allovaro/minecraft-jukebox-nfc/cad/inside.png

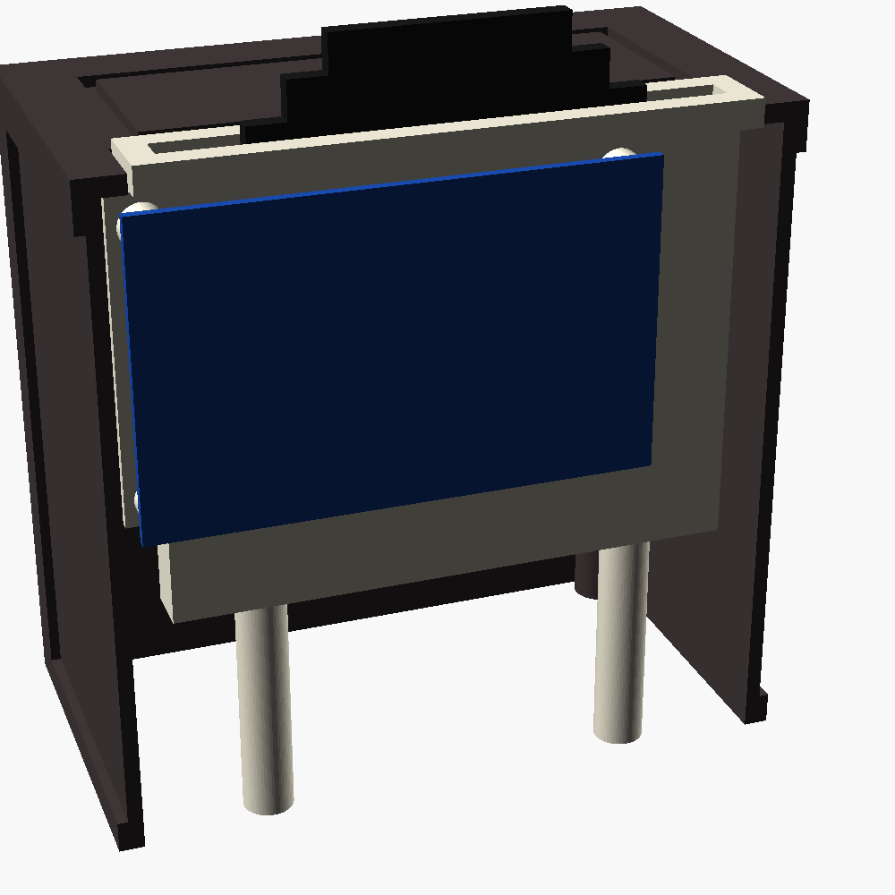
cad/inside.png
