allovaro/minecraft-jukebox-nfc/cad/stl/slot_unit.stl

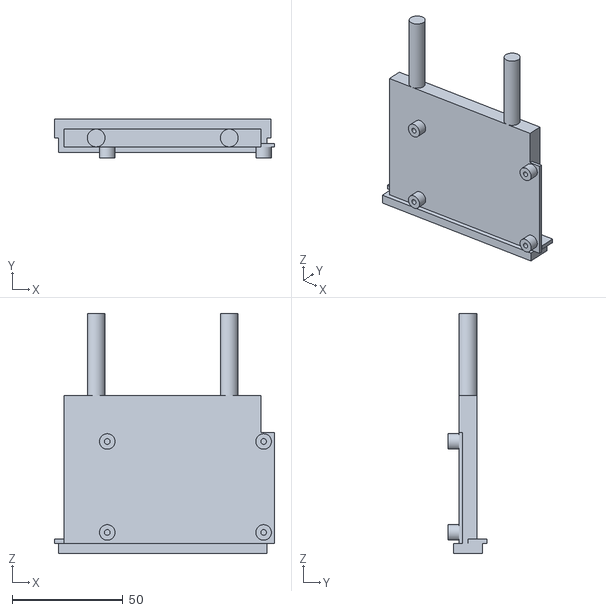
[picture p3: CAD file, 2026-10-28]
cad/stl/slot_unit.stl
99.4 x 17.5 x 108.2
