allovaro/minecraft-jukebox-nfc/cad/stl/body.stl

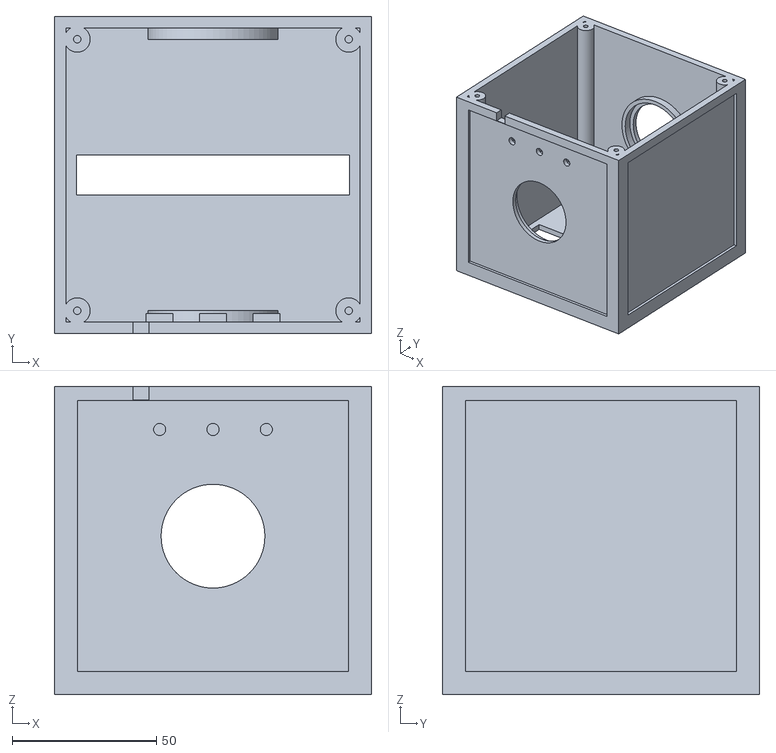
[picture p4: CAD file, 2026-10-28]
cad/stl/body.stl
110.0 x 110.0 x 107.0
