allovaro/minecraft-jukebox-nfc/cad/stl/disc.stl

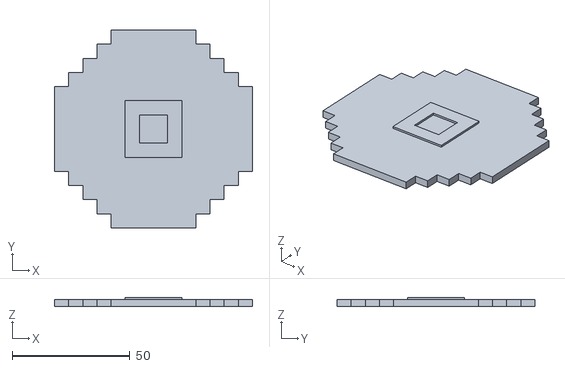
[picture p5: CAD file, 2026-10-28]
cad/stl/disc.stl
84.0 x 84.0 x 3.80
