allovaro/minecraft-jukebox-nfc/cad/stl/bottom.stl

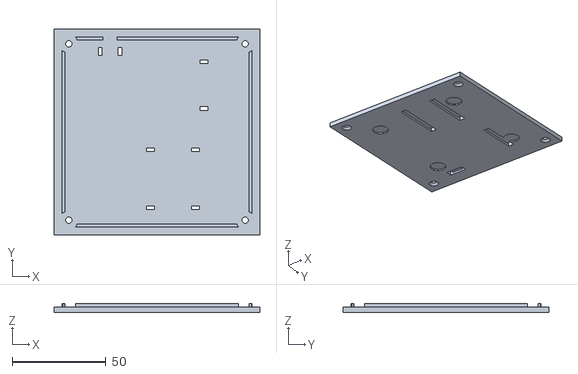
[picture p6: CAD file, 2026-10-28]
cad/stl/bottom.stl
110.0 x 110.0 x 5.00
