allovaro/minecraft-jukebox-nfc/cad/stl/panel_top.stl

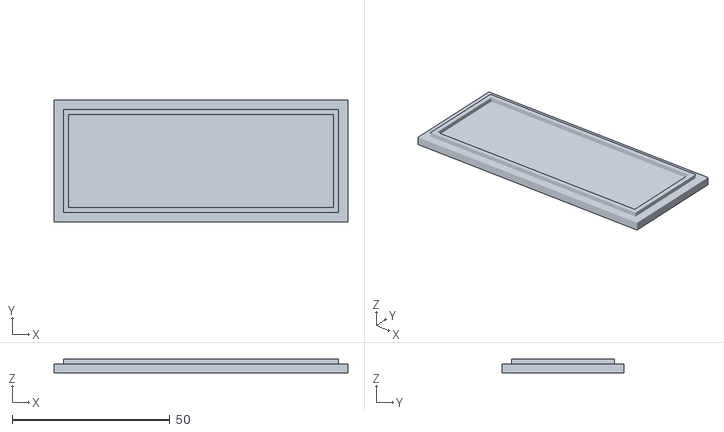
[picture p7: CAD file, 2026-10-28]
cad/stl/panel_top.stl
93.3 x 38.6 x 4.30
