allovaro/minecraft-jukebox-nfc/cad/stl/panel_side.stl

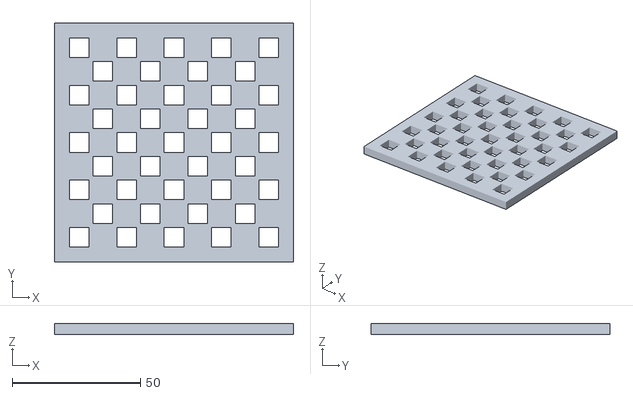
[picture p8: CAD file, 2026-10-28]
cad/stl/panel_side.stl
93.3 x 93.3 x 4.40
