allovaro/minecraft-jukebox-nfc/(commit log)

2026-10-28 Minecraft jukebox: NFC music box for kids
    ESPHome firmware (ESP32-S3, PN532, MAX98357A, WS2812), Home Assistant
    automation, parametric OpenSCAD model with ready-to-print STLs.
    [body.stl, bottom.stl, disc.stl, music_cube.scad, panel_side.stl, panel_top.stl, slot_unit.stl]
2026-10-28 Fix issues found in model audit
    - Speaker rings and button holders are now open (0.1 mm skin removed)
    - Power cable exits through a notch under the back wall, with zip-tie strain relief
    - Slot unit clamped between roof and bottom plate by two legs
    - Looser fits for slot rim, top panel groove and side panels
    - Taller PN532 standoffs so M3x6 screws fit; zip-tie mounts for ESP32 and amp
    - ESP32 placed with room for the USB-C plug; buttons always centered
    - Correct pause / color-change heights for discs; parameter sanity checks
    [body.stl, bottom.stl, disc.stl, music_cube.scad, panel_side.stl, panel_top.stl, slot_unit.stl]
